nanochord/NorSID/src/client/Resources/Keyboard.png

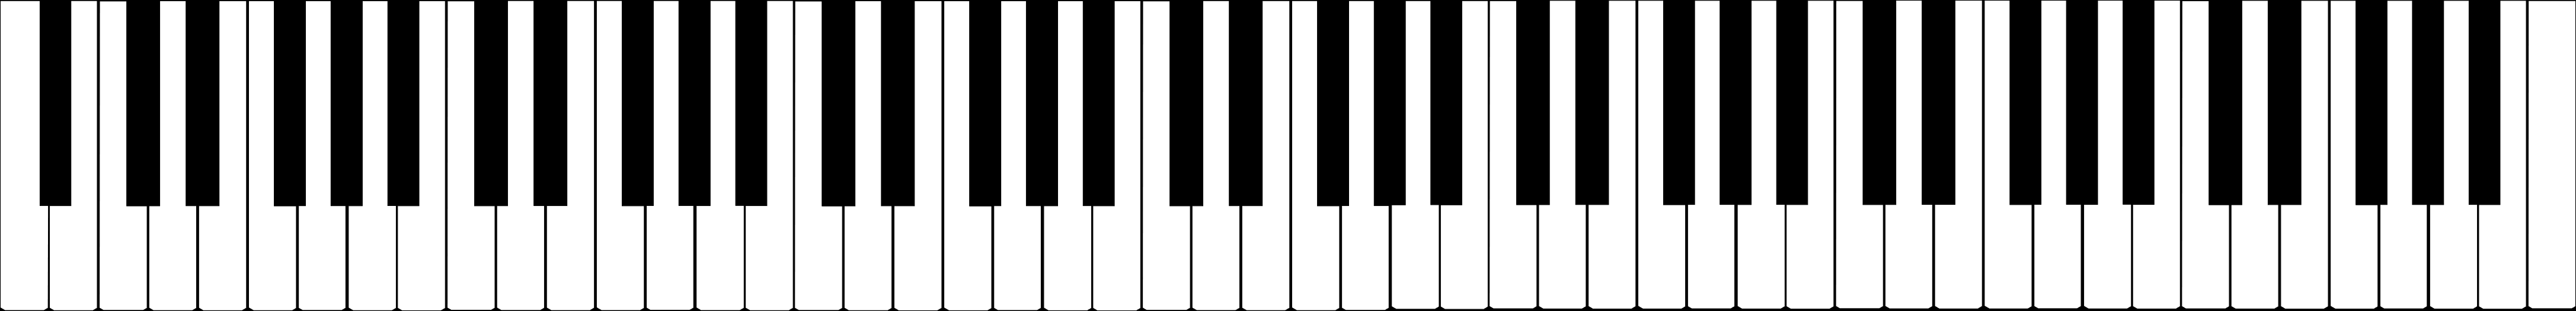
src/client/Resources/Keyboard.png
