nanochord/NorSID/src/sch/norsid.sch

## EAGLE design src/sch/norsid.sch (2024-10-16)

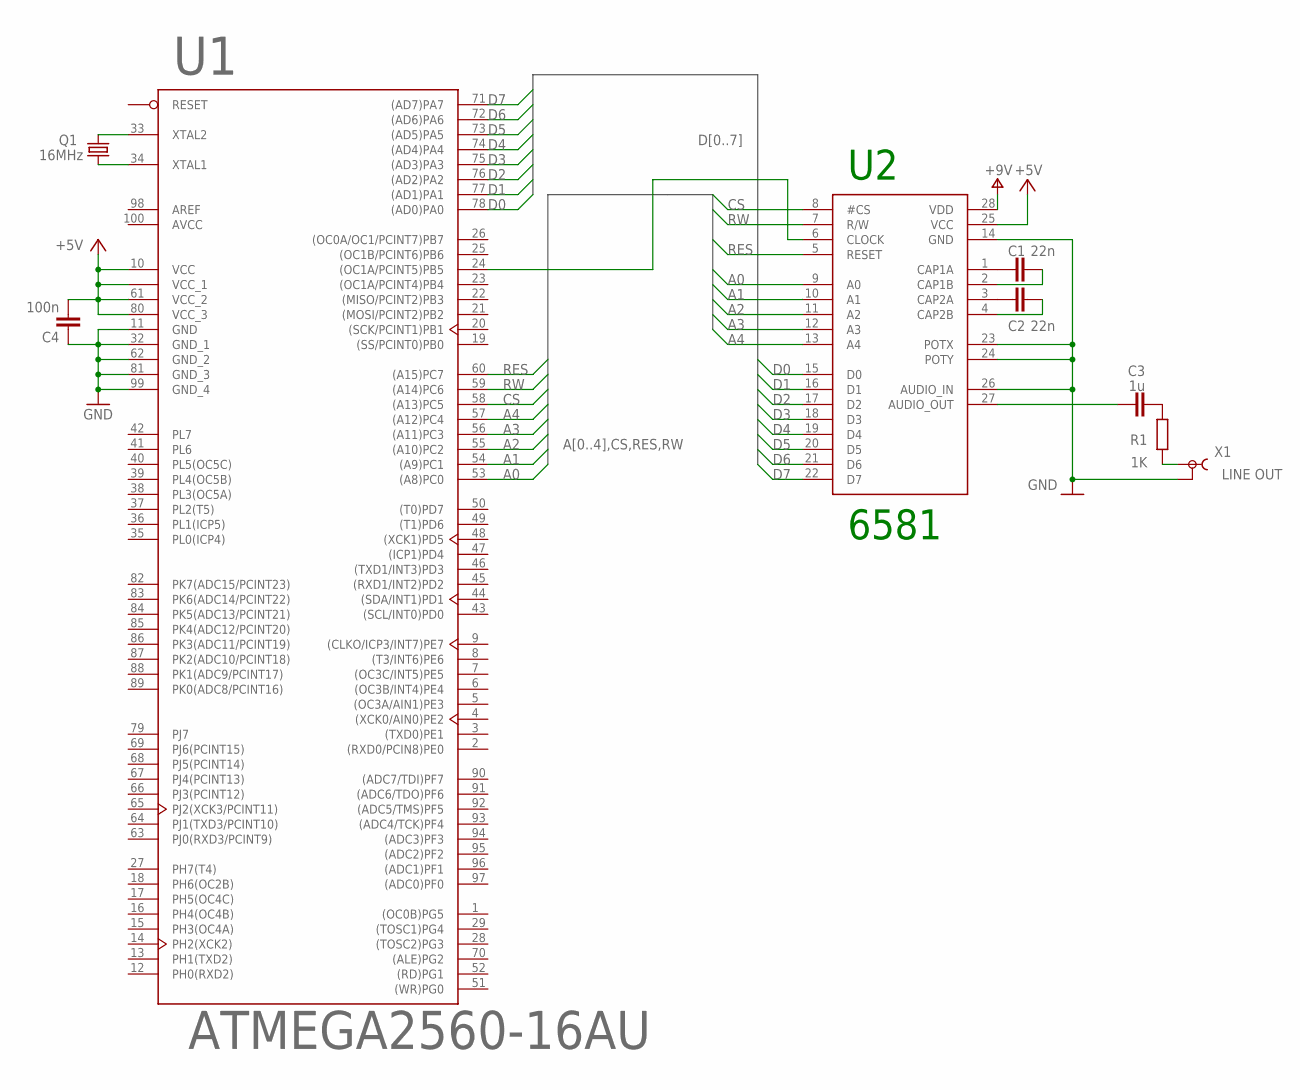
[picture p5: schematic norsid.sch]

Parts:
C1, C2: 22n; C2.5-2
C3: 1u; C2.5-2
C4: 100n; C2.5-2
Q1: 16MHz; HC49U70
U1: ATMEGA2560-16AU; TQFP-100
U2: 6581; DIL28-6
X1: LINE OUT; TOBU3

Connections:
+5V: C4.2, U1.10 (VCC), U1.31 (VCC_1), U1.61 (VCC_2), U1.80 (VCC_3)
A0: U1.53 ((A8)PC0), U2.9 (A0)
A1: U1.54 ((A9)PC1), U2.10 (A1)
A2: U1.55 ((A10)PC2), U2.11 (A2)
A3: U1.56 ((A11)PC3), U2.12 (A3)
A4: U1.57 ((A12)PC4), U2.13 (A4)
CS: U1.58 ((A13)PC5), U2.8 (#CS)
D0: U1.78 ((AD0)PA0), U2.15 (D0)
D1: U1.77 ((AD1)PA1), U2.16 (D1)
D2: U1.76 ((AD2)PA2), U2.17 (D2)
D3: U1.75 ((AD3)PA3), U2.18 (D3)
D4: U1.74 ((AD4)PA4), U2.19 (D4)
D5: U1.73 ((AD5)PA5), U2.20 (D5)
D6: U1.72 ((AD6)PA6), U2.21 (D6)
D7: U1.71 ((AD7)PA7), U2.22 (D7)
GND: C4.1, U1.11 (GND), U1.32 (GND_1), U1.62 (GND_2), U1.81 (GND_3), U1.99 (GND_4)
unnamed: C1.1, U2.1 (CAP1A)
unnamed: C2.1, U2.3 (CAP2A)
unnamed: U2.14 (GND), U2.23 (POTX), U2.24 (POTY), U2.26 (AUDIO_IN), X1.2
unnamed: U1.24 ((OC1A/PCINT5)PB5), U2.6 (CLOCK)
unnamed: C3.1, U2.27 (AUDIO_OUT)
unnamed: C1.2, U2.2 (CAP1B)
unnamed: C2.2, U2.4 (CAP2B)
unnamed: Q1.2, U1.33 (XTAL2)
unnamed: Q1.1, U1.34 (XTAL1)
RES: U1.60 ((A15)PC7), U2.5 (RESET)
RW: U1.59 ((A14)PC6), U2.7 (R/W)
V+: U2.28 (VDD)
VCC: U2.25 (VCC)

Notes on the sheet:
6581
