nanochord/NorSID/src/firmware/SIDProject/uart.h

/*
 * uart.h
 *
 * Created: 2016.06.27. 23:15:26
 * Author: Norbert Laszlo
 */ 


#ifndef UART_H_
#define UART_H_


void uart_putchar(char c, FILE *stream);
char uart_getchar(FILE *stream);

void uart_init(void);

FILE uart_output = FDEV_SETUP_STREAM(uart_putchar, NULL, _FDEV_SETUP_WRITE);
FILE uart_input = FDEV_SETUP_STREAM(NULL, uart_getchar, _FDEV_SETUP_READ);


#endif /* UART_H_ */
