nanochord/NorSID/(commit log)

2024-10-15 First commit of my archive project.
    [norsid.sch]
2024-10-16 Schematic fixed
    [norsid.sch]
2024-10-16 Updating schematic
    [norsid.sch]
